Nathansbud/Clamball/README.md

# Clamball
Repository for mini version of Fascination created for CSCI 1600

Instructions for running:
- run the server - "python server.py"
- wait for connection from both cabinets
- select relevant option ("2" to run the game)

Instructions for testing:
- ensure TESTING is uncommented 
- run as usual
