Nathansbud/Clamball/(commit log)

2024-10-09 basic LED turn on example
2024-10-28 push boilerplate sensor reading tests
2024-12-02 add a todo serial print
2024-12-03 connecting sensors
2024-12-03 calibrating stuff
2024-12-09 replace all print/println with DEBUG_PRINT
    [Clamball.ino, tests.ino]
